oshwabadge2020/Badge-PCB/README.md

# Open Hardware Summit 2020 wrist-watch badge
* [Hackaday.io project page](https://hackaday.io/project/168483-open-hardware-summit-2020-badge)
* [OHS 2020 website](http://2020.oshwa.org/)

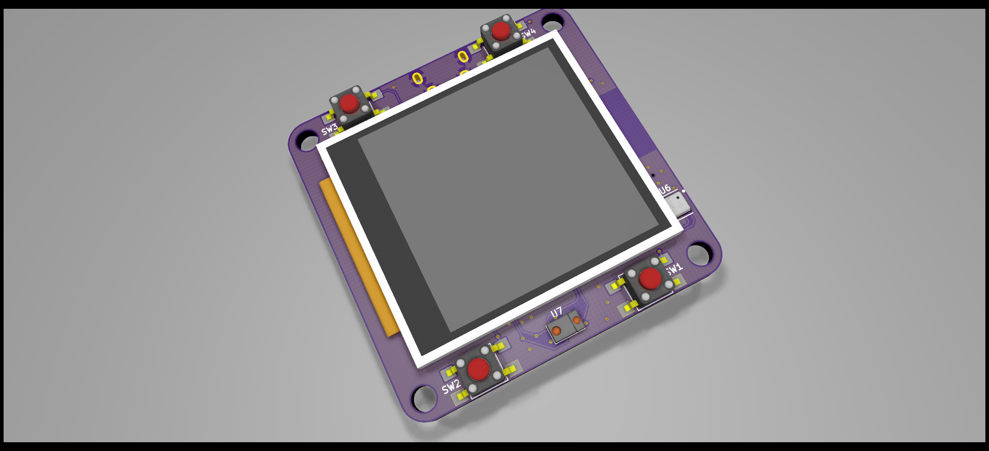
[picture p1: renders/badge-01.png]
Badge top

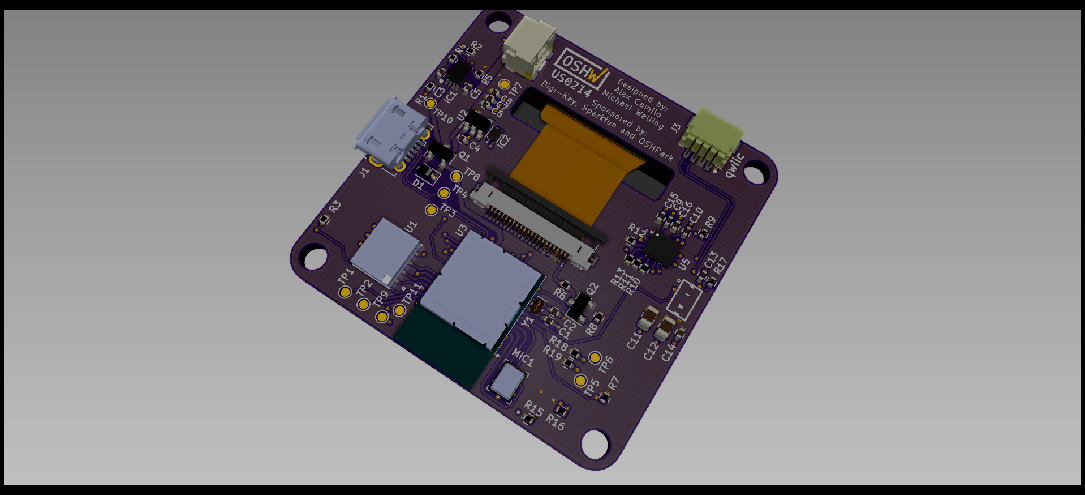
[picture p2: renders/badge-02.png]
Badge bot
