oshwabadge2020/Badge-PCB/3d_part_models/JST_GH_SM04B_SRSS_TB_LF__SN_007.step

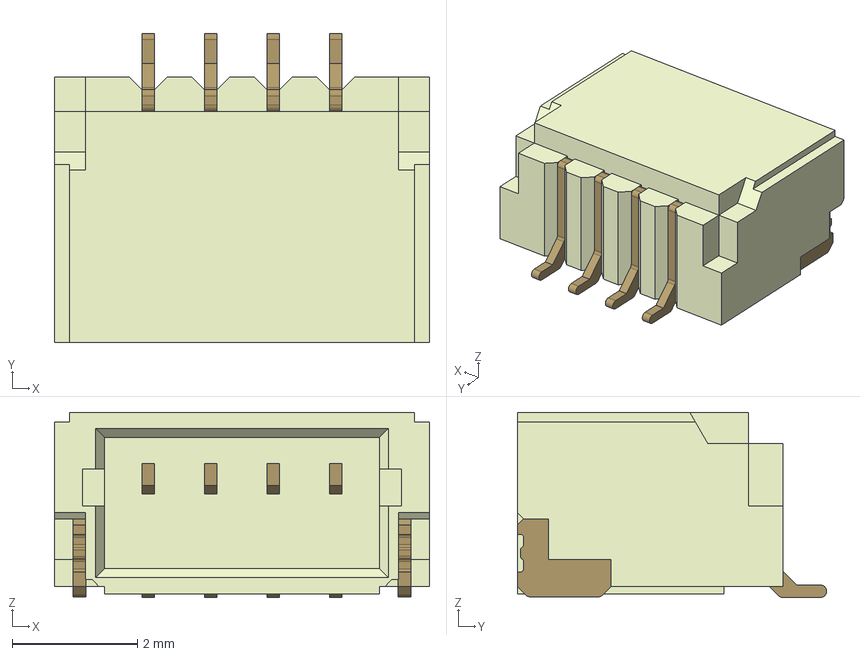
[picture p3: CAD file, 2020-01-16]
3d_part_models/JST_GH_SM04B_SRSS_TB_LF__SN_007.step
6.00 x 4.95 x 2.96 mm
