oshwabadge2020/Badge-PCB/CAD/TFT_LCD.step

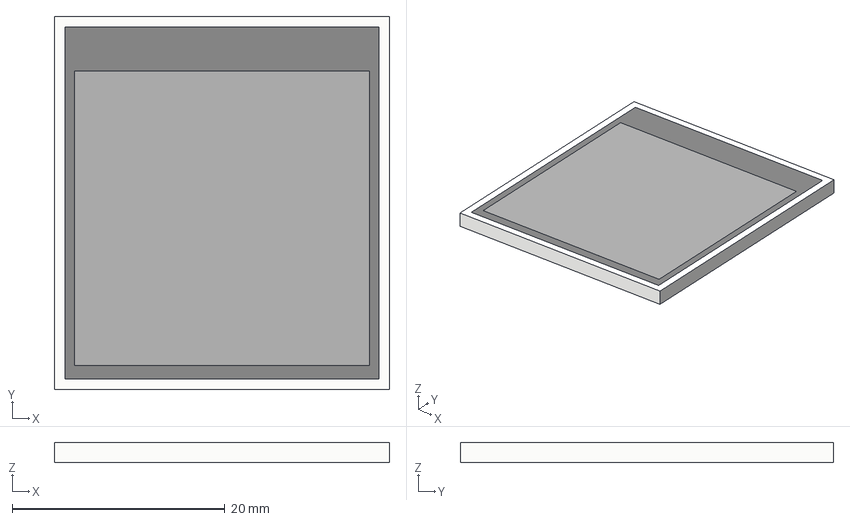
[picture p4: CAD file, 2020-01-14]
CAD/TFT_LCD.step
31.5 x 35.1 x 1.90 mm
TFT_1.54IN_240X240_22PIN
TFT_1.54IN_240X240_22PIN001
TFT_1.54IN_240X240_22PIN002
