oshwabadge2020/Badge-PCB/3d_part_models/TFT_LCD_4421.step

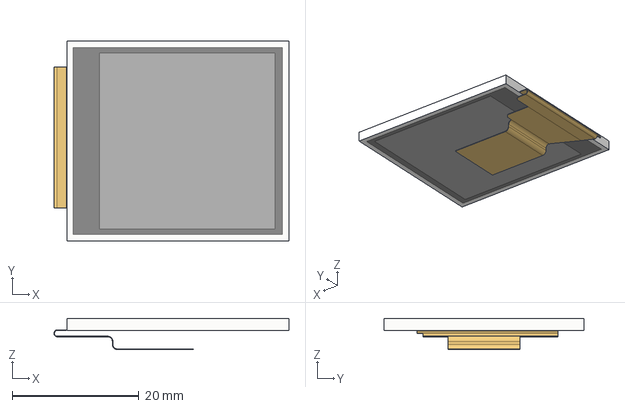
[picture p5: CAD file, 2020-01-14]
3d_part_models/TFT_LCD_4421.step
37.1 x 31.5 x 4.90 mm
