oshwabadge2020/Badge-PCB/3d_part_models/xtal_CM9V-T1A.step

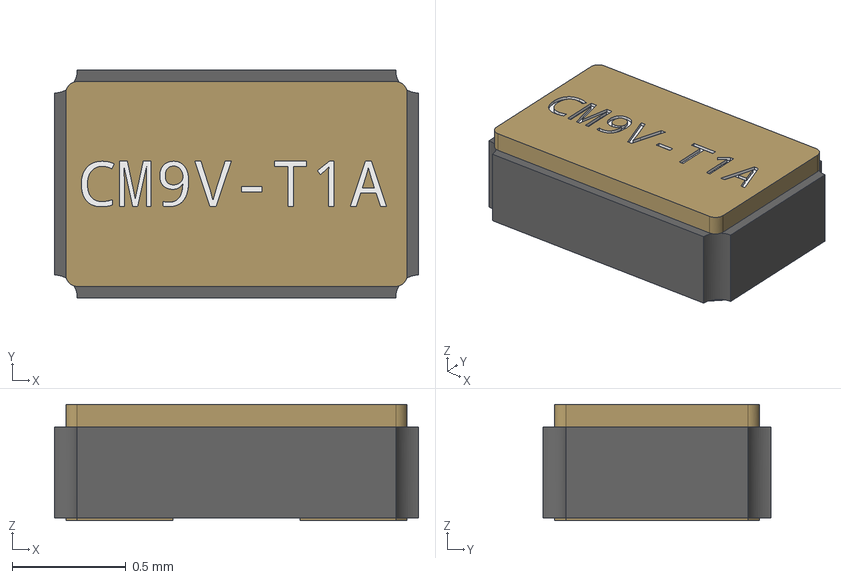
[picture p6: CAD file, 2020-01-12]
3d_part_models/xtal_CM9V-T1A.step
1.60 x 1.00 x 0.51 mm
