oshwabadge2020/Badge-PCB/3d_part_models/SNT-4A.step

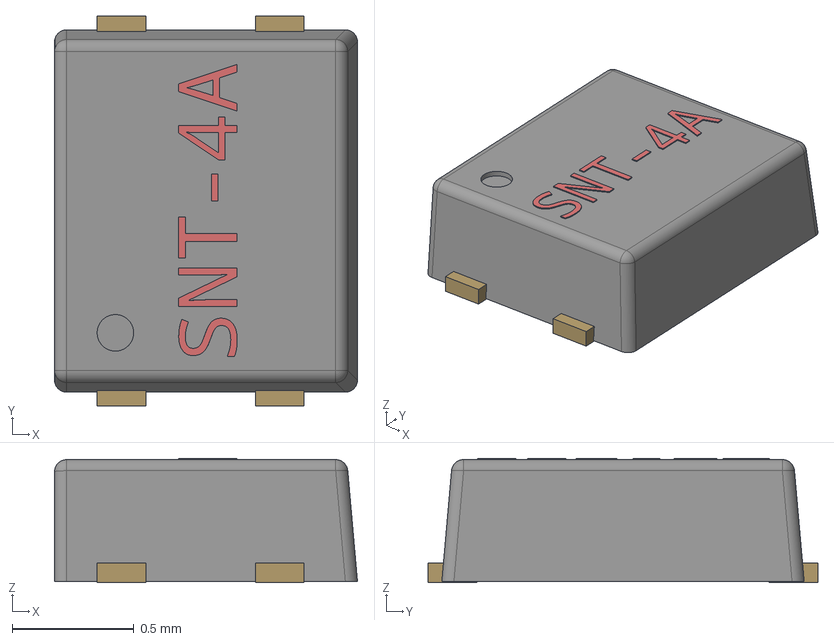
[picture p7: CAD file, 2020-01-12]
3d_part_models/SNT-4A.step
1.24 x 1.60 x 0.51 mm
