oshwabadge2020/Badge-PCB/3d_part_models/SON127P600X500X80-9N.step

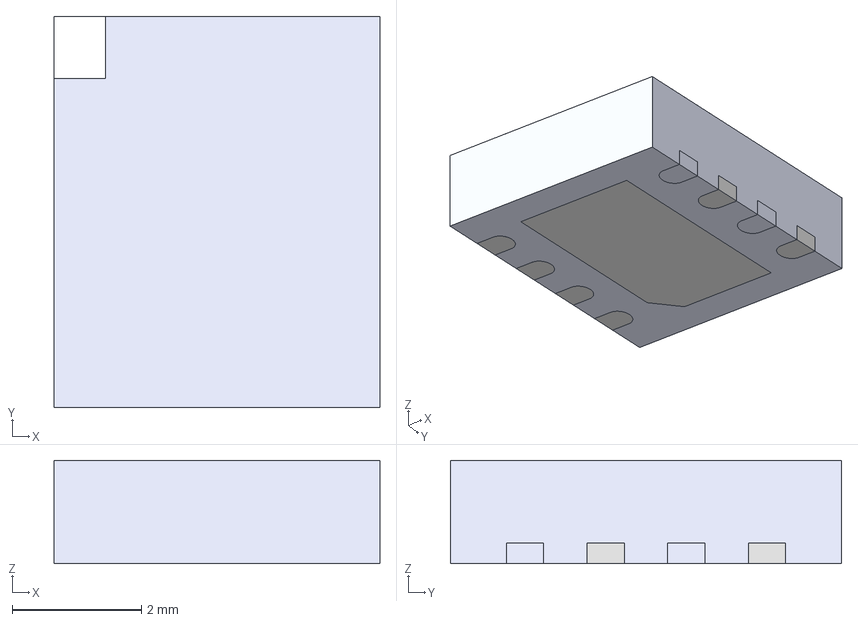
[picture p8: CAD file, 2020-01-12]
3d_part_models/SON127P600X500X80-9N.step
5.04 x 6.05 x 1.60 mm
