oshwabadge2020/Badge-PCB/3d_part_models/JST_GH_SM02B-GHS-TB_1x02-1MP_P1.25mm_Horizontal.step

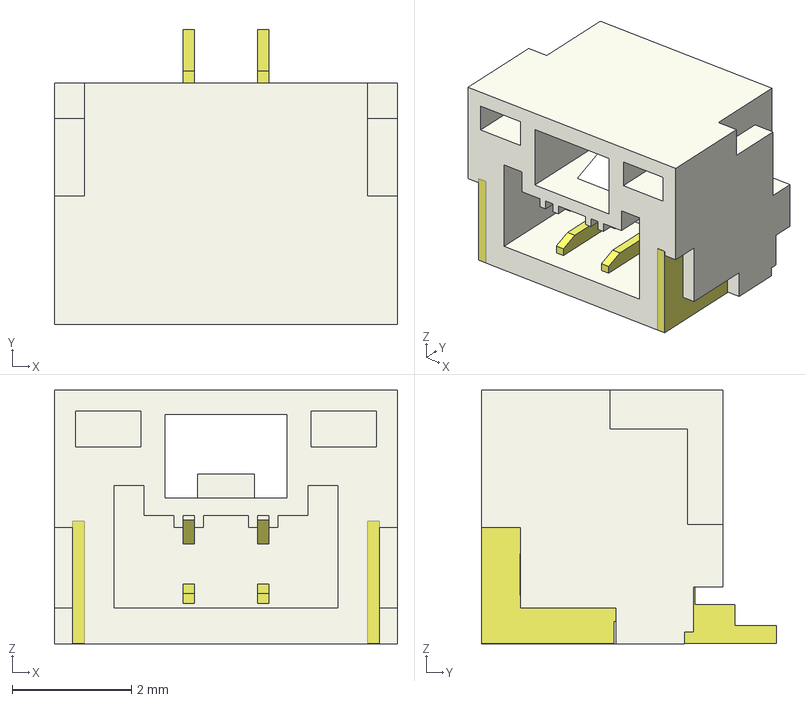
[picture p9: CAD file, 2020-01-12]
3d_part_models/JST_GH_SM02B-GHS-TB_1x02-1MP_P1.25mm_Horizontal.step
5.75 x 4.95 x 4.25 mm
