oshwabadge2020/Badge-PCB/3d_part_models/USB-MicroB_Molex_105017.step

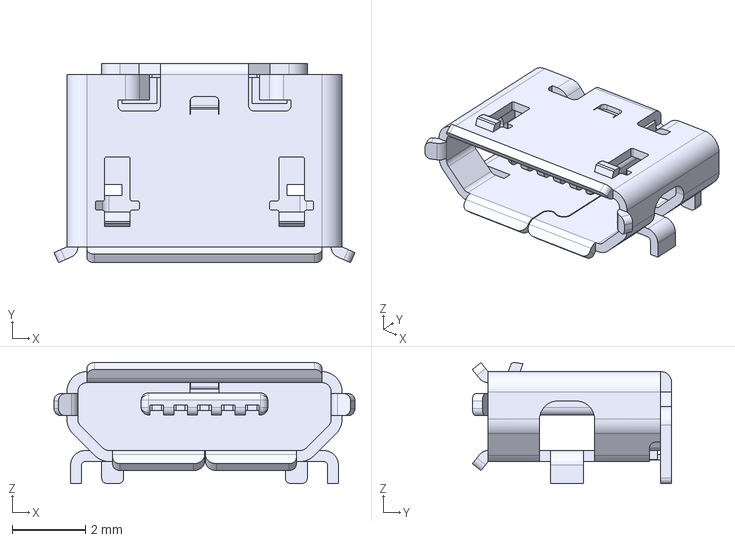
[picture p10: CAD file, 2020-01-12]
3d_part_models/USB-MicroB_Molex_105017.step
8.20 x 5.43 x 3.30 mm
