oshwabadge2020/Badge-PCB/3d_part_models/BME680_cp.step

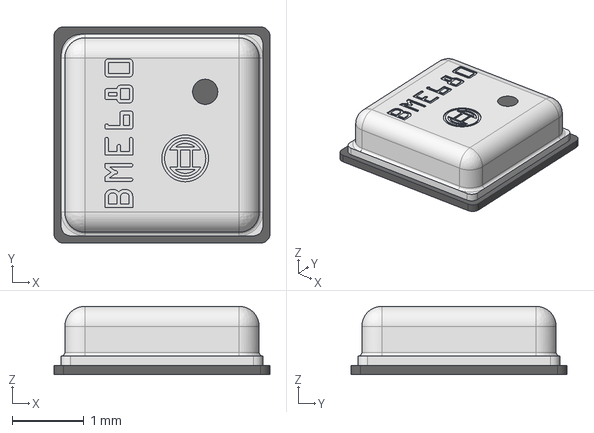
[picture p11: CAD file, 2020-01-12]
3d_part_models/BME680_cp.step
3.00 x 3.00 x 0.95 mm
