oshwabadge2020/Badge-PCB/3d_part_models/LGA-24L_3.5x3_0.43p.step

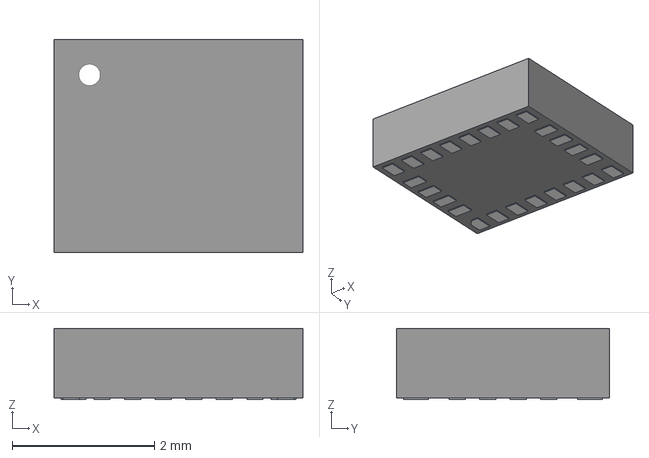
[picture p12: CAD file, 2020-01-12]
3d_part_models/LGA-24L_3.5x3_0.43p.step
3.50 x 3.00 x 1.00 mm
