oshwabadge2020/Badge-PCB/3d_part_models/SPH0645LM4H_B009.step

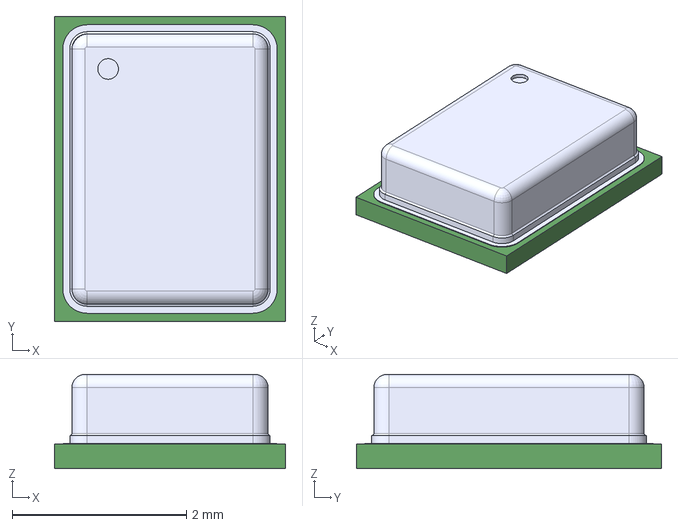
[picture p13: CAD file, 2020-01-12]
3d_part_models/SPH0645LM4H_B009.step
2.65 x 3.50 x 1.08 mm
