oshwabadge2020/Badge-PCB/3d_part_models/APDS_9962.step

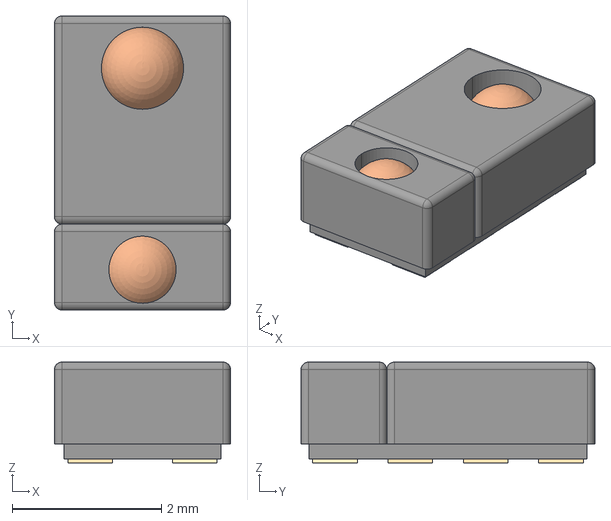
[picture p14: CAD file, 2020-01-12]
3d_part_models/APDS_9962.step
2.36 x 3.94 x 1.35 mm
