oshwabadge2020/Badge-PCB/3d_part_models/TL3305AFxxxxG.step

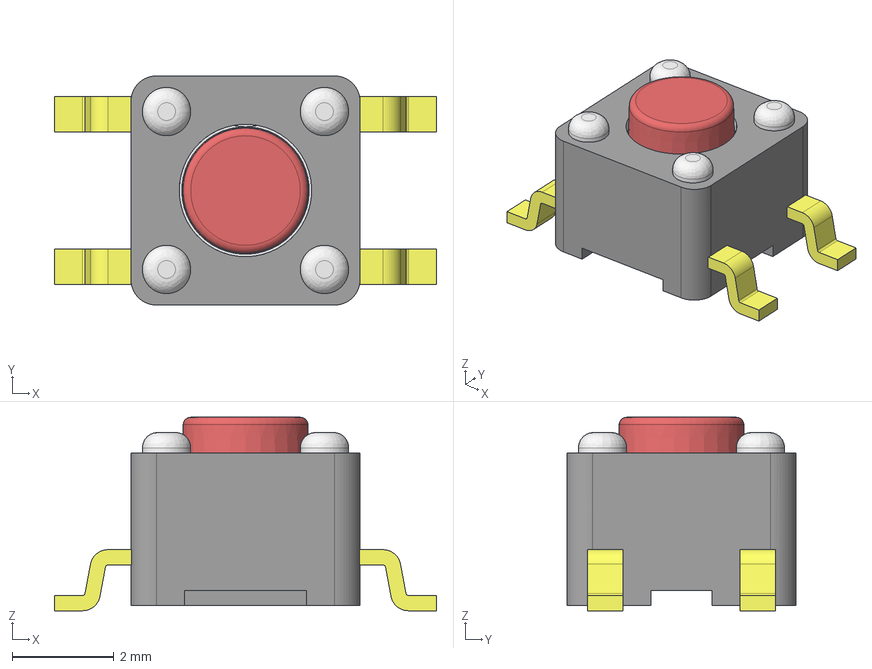
[picture p15: CAD file, 2020-01-12]
3d_part_models/TL3305AFxxxxG.step
7.50 x 4.50 x 3.80 mm
