oshwabadge2020/Badge-PCB/3d_part_models/BMD_340_A_R077.step

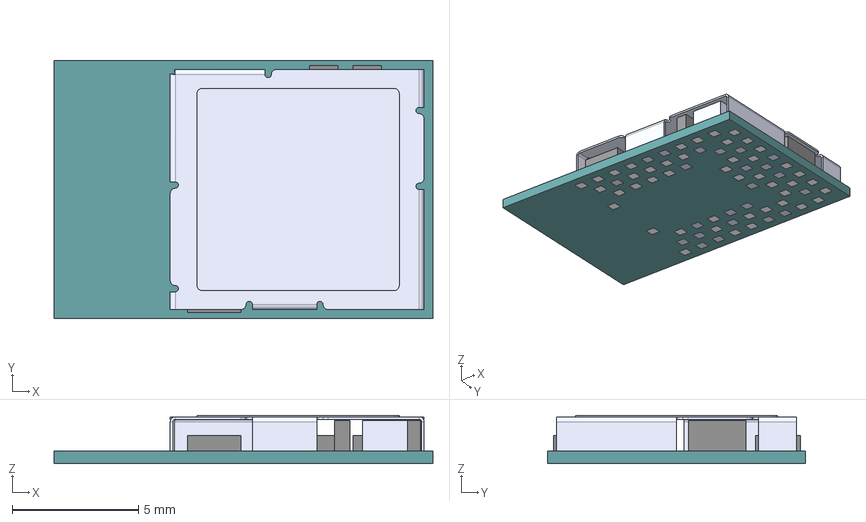
[picture p16: CAD file, 2020-01-12]
3d_part_models/BMD_340_A_R077.step
15.0 x 10.2 x 1.90 mm
