oshwabadge2020/Badge-PCB/3d_part_models/C_0805_2012Metric.step

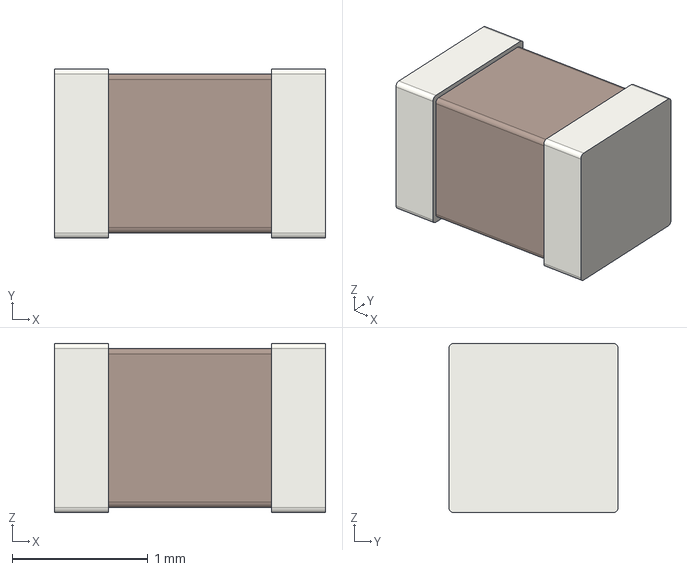
[picture p17: CAD file, 2020-01-11]
3d_part_models/C_0805_2012Metric.step
2.00 x 1.25 x 1.25 mm
