oshwabadge2020/Badge-PCB/3d_part_models/DFN8_2x3MC-L.step

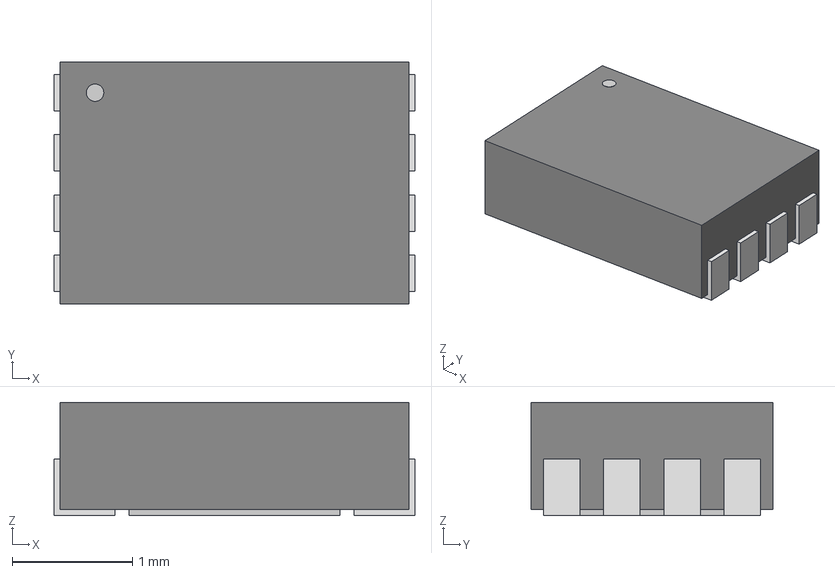
[picture p18: CAD file, 2020-01-11]
3d_part_models/DFN8_2x3MC-L.step
3.00 x 2.01 x 0.942 mm
