oshwabadge2020/Badge-PCB/3d_part_models/SOT-23.step

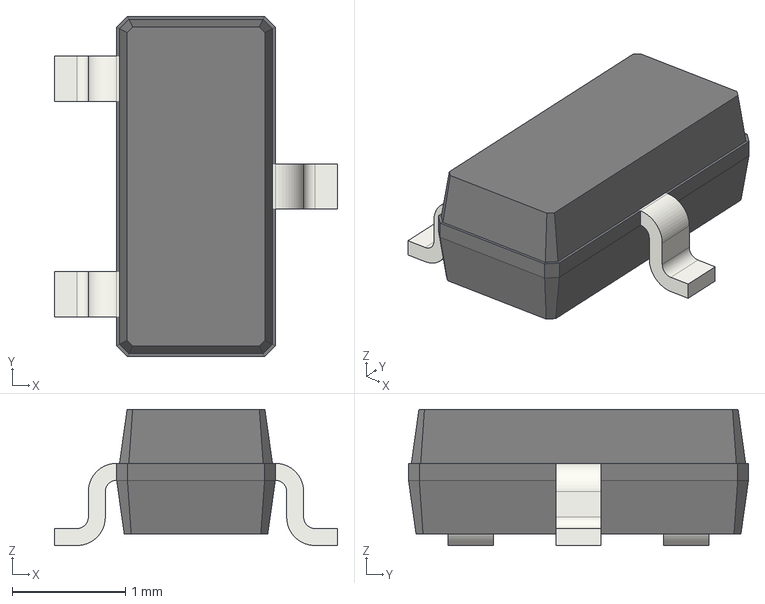
[picture p19: CAD file, 2020-01-11]
3d_part_models/SOT-23.step
2.50 x 3.00 x 1.20 mm
