oshwabadge2020/Badge-PCB/3d_part_models/D_SOD-323.step

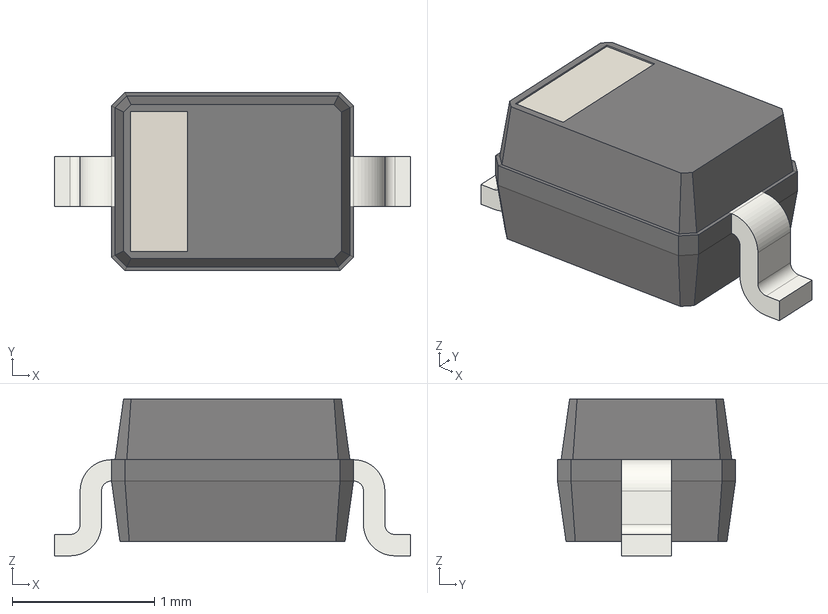
[picture p20: CAD file, 2020-01-11]
3d_part_models/D_SOD-323.step
2.50 x 1.25 x 1.10 mm
