oshwabadge2020/Badge-PCB/3d_part_models/TL3305CFxxxxG.step

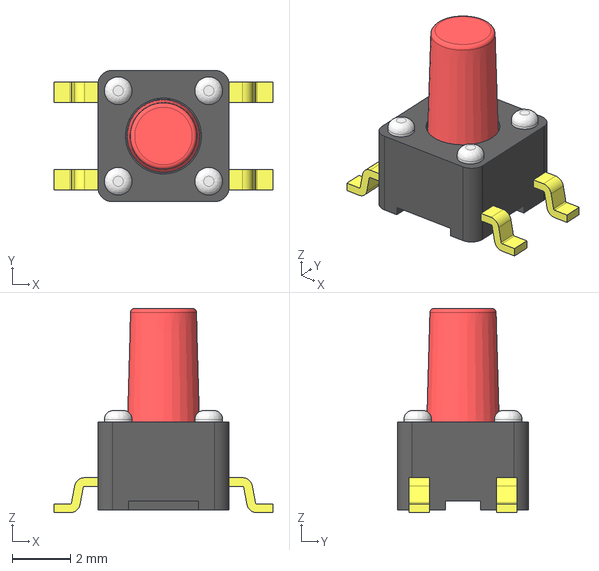
[picture p21: CAD file, 2020-01-11]
3d_part_models/TL3305CFxxxxG.step
7.50 x 4.50 x 7.00 mm
