oshwabadge2020/Badge-PCB/3d_part_models/C_0402_1005Metric.step

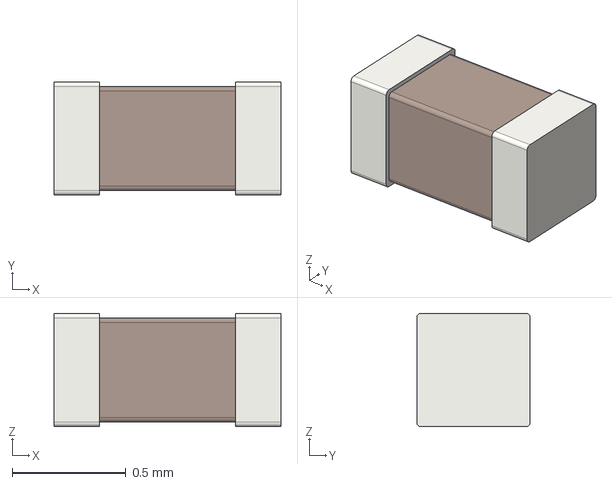
[picture p22: CAD file, 2020-01-11]
3d_part_models/C_0402_1005Metric.step
1.00 x 0.5 x 0.5 mm
