oshwabadge2020/Badge-PCB/3d_part_models/SOT-23-5.step

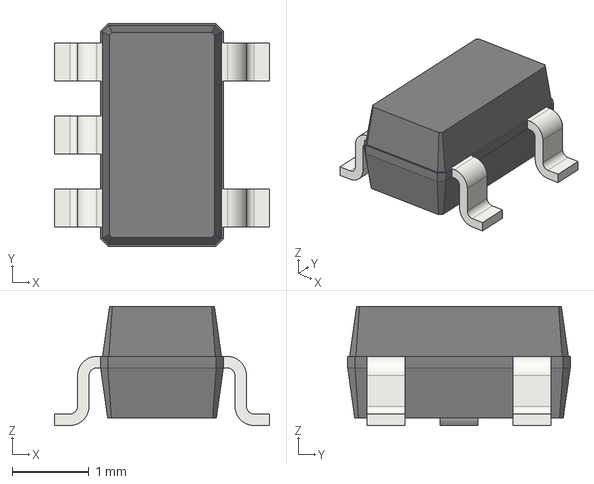
[picture p24: CAD file, 2020-01-11]
3d_part_models/SOT-23-5.step
2.80 x 2.90 x 1.55 mm
