oshwabadge2020/Badge-PCB/3d_part_models/LED_SK6812_PLCC4_5.0x5.0mm_P3.2mm.step

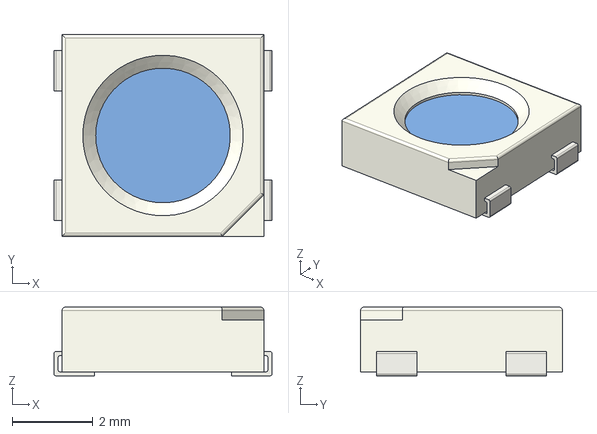
[picture p25: CAD file, 2020-01-11]
3d_part_models/LED_SK6812_PLCC4_5.0x5.0mm_P3.2mm.step
5.40 x 5.00 x 1.70 mm
