oshwabadge2020/Badge-PCB/(list of files, cad)

Other CAD files:
3d_part_models/JST_GH_SM04B-SRSS-TB.FCStd
3d_part_models/SM04B-SRSS-TB(LF)(SN)--3DModel-STEP-56544.step
3d_part_models/TFT_1_54IN_240X240_22PIN.step
3d_part_models/xtal.step
3d_part_models/DFN8_2x3MC-M.step
3d_part_models/DFN8_2x3MC.step
3d_part_models/0545482271.step
