oshwabadge2020/Badge-PCB/(threads)

Thread 1 (2019-12-12):

warning when opening schematic in KiCad 5.1

pdp7, 2019-12-12:
I got a warning when opening in KiCad 5.1 that the schematic was made using older symbol libraries which may break the schematic.  The reference was U1: W25Q128JVS

Here is screenshot:
Image: https://photos.app.goo.gl/DeDS7NZ7dhekTugQ7

I just thought I would check to see if this is an issue.

thanks,
drew

morganrallen, 2020-01-11:
This is also likely why the models aren't loading as per your .io post. Was this started in an older version of KiCAD? 4.0.7 maybe

Closed 2020-01-13.

Thread 2 (2019-12-13):

part number of LCD?

pdp7, 2019-12-13:
This is the LCD that I asked Kevin at Digikey about ordering from Adafruit.

1.54" 240x240 Color IPS TFT Display PRODUCT ID: 4421
https://www.adafruit.com/product/4421

Is this correct?

pdp7, 2019-12-15:
@acamilo on Hackaday.io chat today:
> the 1.3" adafruit LCD breakout. The Module with FFC connector. There are a couple of variants. there is a 1.54" with a FFF and a 1.3" with hotbar.  we don't want thoes.
we want the one  that is 1.3" with a FFC.

Kevin at Digi-Key has ordered:
* Adafruit 1.54" 240x240 Color IPS TFT Display PRODUCT ID: 4421

I just emailed Kevin and Phil at Adafruit to see if it is possible to get the display from:
* Adafruit 1.3" 240x240 Wide Angle TFT LCD Display with MicroSD - ST7789 (PRODUCT ID: 4313)

@acamilo it might be too late to change though.  Could you help me understand why we can not use Adafruit 1.54" 240x240 Color IPS TFT Display (PRODUCT ID: 4421)?

pdp7, 2019-12-16:
To followup, @acamilo told me on Hackaday chat that the case he found only fits the 1.3"

Phil replied to me that the 1.3" can not be sourced.

The solution is that we will go with the 1.54" and try to find a different case.

pdp7, 2019-12-16:
In conclusion: we will be using this display:

Adafruit 1.54" 240x240 Color IPS TFT Display PRODUCT ID: 4421

Closed 2019-12-16.

Thread 3 (2019-12-13):

use case for microphone?

pdp7, 2019-12-13:
I see the SPH0645LM4H-B is a microphone.

What sort of functionality where you thinking about for that?

@mwelling had mentioned TensorFlow Lite when we were talking about Artemis.  I wonder if that is still possible on the nRF52840

mwelling, 2019-12-13:
https://www.tensorflow.org/lite/microcontrollers

It should be possible with a fair amount of work.

I tried the Tensorflow Lite demo on the Edge Badge from Adafruit and it could not recognize me saying "yes".

I think that there were similar complaints about the SparkX Edge demo.

If we want to teach the module different words we will have to create a new model and quantize it for use with Tensorflow Lite.

pdp7, 2019-12-16:
@acamilo @mwelling OK, let's keep this on the "nice to have list".  If cost or board layout becomes issue, then I think we could drop the microphone.

sound ok?

mwelling, 2019-12-16:
Yes.

Closed 2020-01-13.

Thread 5 (2019-12-23):

layout: single board or 2 stacked boards?

pdp7, 2019-12-23:
I see that @mwelling is experimenting with a two board design based on the initial design by @acamilo.

Alex / Michael - do you think this will increase the complexity for SparkFun to assemble?  could we get away with one board, or do we have too many features to pack in to that space?

@nseidle @npoole would two boards for the OHS wristwatch badge be acceptable for sparkfun assembly?

thanks!

mwelling, 2019-12-23:
The boards will be a single assembly connected by mouse bites. It should not be any more difficult to assemble than a single board.

pdp7, 2019-12-24:
fyi - from the project chat:
[Stacking boards and wrist mounting options](
https://hackaday.io/project/168483-open-hardware-summit-2020-badge/log/172231-stacking-boards-and-wrist-mounting-options)

Closed 2020-01-13.

Thread 6 (2019-12-23):

Schematic: TFT part not found

pdp7, 2019-12-23:
@mwelling @acamilo I get this error when opening the schematic:
https://drive.google.com/file/d/1yV3evtUtcjzEU9EdJwjOczyqiNKNChYE/view?usp=sharing
https://drive.google.com/file/d/1z54ayqx_C5wUFP1OZ-xiHHbq0OHI8Zy6/view?usp=sharing

mwelling, 2019-12-23:
You just need to change to a relative path in the library path.

Lemme fix it on my fork.

mwelling, 2019-12-23:
https://github.com/mwelling/Badge-PCB/commit/2f8b797bd9968c6d512afe70e5037b96edf8f7c1

Closed 2020-01-13.

Thread 7 (2019-12-23):

Generate gerbers for review

nseidle, 2019-12-23:
I am not a proficient Kicad user. If possible, could you generate gerbers so I can review?

mwelling, 2019-12-23:
Yes we can provide Gerbers and PDF plots when we are ready for review.

pdp7, 2020-01-13:
For those without KiCad:

Gerbers:

https://github.com/oshwabadge2020/Badge-PCB/tree/master/gerbers

Schematic PDF:

https://github.com/oshwabadge2020/Badge-PCB/tree/master/schematic.pdf

OSH Park renders:

Here is PDF of layer preview from OSH Park:

https://hackaday.io/project/168483-open-hardware-summit-2020-badge/files

ZIP of the layer renders:

https://cdn.hackaday.io/files/1684837208376672/OSH%20Park%20_%20Verify%20your%20design.zip

OSH Park shared project has hi res top and bottom render:

https://oshpark.com/shared_projects/DU7vUFIe

Closed 2020-01-14.

Thread 15 (2020-01-13):

review layout before fab

pdp7, 2020-01-13:
Thanks so much to @mwelling  for finishing routing the badge:
https://github.com/oshwabadge2020/Badge-PCB/pull/14

Michael used 2 layers for the initial prototypes so we can fab them faster.  There are only 8 weeks left until the Open Hardware Summit on March 13th.

For those without KiCad:
* Gerbers: https://github.com/oshwabadge2020/Badge-PCB/tree/master/gerbers
* Schematic PDF:https://github.com/oshwabadge2020/Badge-PCB/tree/master/schematic.pdf

OSH Park renders:
* Here is PDF of layer preview from OSH Park: https://hackaday.io/project/168483-open-hardware-summit-2020-badge/files
* ZIP of the layer renders: https://cdn.hackaday.io/files/1684837208376672/OSH%20Park%20_%20Verify%20your%20design.zip
* OSH Park shared project has hi res top and bottom render: https://oshpark.com/shared_projects/DU7vUFIe

Related Hackaday.io post:
https://hackaday.io/project/168483-open-hardware-summit-2020-badge/log/172923-help-review-layout-before-fab

pdp7, 2020-01-13:
@Junes-PhD @Anool @acamilo @morganallen

Anool, 2020-01-13:
1. MIC1 hole needs to be 1mm per the [datasheet](https://github.com/oshwabadge2020/Badge-PCB/blob/master/datasheets/mic_SPH0645LM4H-B.pdf)

2. Some of the legend text is getting subtracted by Via's. You might want to move them around a bit for better visibility.

3. You might want to add some descriptive text/link about the project on the PCB silk legend.

I'll get time to take a closer look tonight,

Anool, 2020-01-13:
4. U7 Gesture sensor has silk outline on both sides of the PCB

ShawnHymel, 2020-01-13:
I believe that Q1 needs to be a P-channel MOSFET (as opposed to an N-channel). The body diode on the FET needs to allow current from +BATT to VBUS when the USB is not plugged in. I usually use Jim's design here for reference when I'm doing similar power circuitry: https://cdn.sparkfun.com/assets/learn_tutorials/5/0/7/esp32-thing-schematic.pdf

ShawnHymel, 2020-01-13:
Are 2 10uF capacitors needed at the output of U2? The datasheet for the S-1318 (https://www.mouser.com/pdfdocs/S1318_E.pdf) claims that you only need a single 1.0 uF at the output, so 2x 10uF might be overkill (and 10uFs can be a little pricey).

ShawnHymel, 2020-01-13:
Can the S-1318 produce enough power? The datasheet says that it's limited to 100mA. In my experience, for the APDS-9960 to detect gestures, it needs to enable a "BOOST" IR LED that can suck up to 100 mA in short bursts.

ShawnHymel, 2020-01-13:
According to 6.1 in the BME680 datasheet (https://www.bosch-sensortec.com/media/boschsensortec/downloads/datasheets_1/bst-bme680-ds001.pdf), you need to pull CSB up for I2C mode. Pulling it down activates SPI comms and disables I2C on the device.

ShawnHymel, 2020-01-13:
C15 may not be necessary if you've got bulk decoupling from the other 10uFs all over the board.

ShawnHymel, 2020-01-13:
What purpose do the D+ and D- test points serve? Will you actually be probing/sniffing USB traffic? I recommend not having test points for these lines, as they can create stubs on the differential pair for your data lines, which can cause reflections and mess up USB traffic.

schneider42, 2020-01-13:
Major:
 - Display IM0,IM1,IM2 usage is different from the one in the Rev G schematic from Adafruit
 - CSB of BME680 needs to be tied high to select I2C
 - Partnumber of SPI flash does not match package (should be W25Q32JVZP I guess)

Minor:
 - Maybe put the output of D3 onto a pad
 - Check size of solder mask defined pads of 0402s when doing a VCC/GND pour

Questions:
 - LDO has abs. max of 120 mA. I guess it is enough. Just wanted to verify.
 - Is 3.0 V enough for the backlight? Datasheet says 3.0 V _typical_

I didn't check much in the layout yet. Might have some more time tomorrow.

mwelling, 2020-01-13:
It is appears that Q1 and Q3 should both be P-channel MOSFETs. Switched to AO3401A.
Q2 looks wired wrong; switching it to P-channel high side switch as well to keep the BOM simple.

Beefed up U2 by using AP2112K-3.3V which gives us 600mA and 3.3V

CSB is now pulled up instead of down.

Switched the PN of U1 to W25Q32JVZPIQ.

Fixed the wiriing of IM0-IM2.

Looks like LCD_BL is not connected to a GPIO. Adding it.

Microphone pattern was not changes the AP diameter is as specified.

Soldermask defined pads should be okay.

We can tweak silkscreen and soldermask before final cut.

The test pads on the USB I assume are for use with a test fixture. Will check with Alex.

mwelling, 2020-01-13:
Updates are on my fork for verification:
https://github.com/mwelling/Badge-PCB

Please check my changes and make sure I didn't do something stupid.

mwelling, 2020-01-13:
The changes have been merged to this repo as well.

Junes-PhD, 2020-01-15:
*Probably minor notes*

RF layout recommendation for BMD-340 say to have a 4.4mm clear strip of
copper.  Wrapping the mic and copper pour around that antenna will reduce
range but not sure how much.  If the application is hand to phone it should
be fine but it's non-ideal for long mesh stuff and may need more broadcast
power.
BMD-340 Datasheet
<https://rigado.sharepoint.com/sites/Public/Shared%20Documents/Forms/AllItems.aspx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>
pg. 21

3V3 maybe better without big flood.  I would at least prefer to switch to
thermal relief for more consistent temperature rise on pads.

USB crosses over SPI lines and doesn't have continuous ground plane

ESD protection  maybe a good idea. USB lines and Switch inputs.

On Mon, Jan 13, 2020 at 3:08 PM Michael Welling <notifications@github.com>
wrote:

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

mwelling, 2020-01-15:
Thanks @Junes-PhD! Will take a look.

FYI. I just flipped the source and drain on Q2 on my repo. This makes it a proper load switch.

We need to change the circuitry on the RBG LEDs as it's FET is backwards as well and has 5V going to the BMD inputs. Was thinking we could maybe use a tps22919 or similar for the load switch.

pdp7, 2020-01-15:
@mwelling I've merged in your fix for Q2 https://github.com/oshwabadge2020/Badge-PCB/commit/d8f25c52f77bb43815fccb44903c51dd587437b2  thank you

mwelling, 2020-01-16:
So we sent off the boards to fab for initial protos.

Thank you to everyone that reviewed the design.

schneider42, 2020-01-17:
Good Luck!

schneider42, 2020-01-17:
One more thing from my side:

The AP2112K has a rather high quiescent current of 55 uA when active (which it will be unless the battery is empty). That will limit how long the RTC is be able to run after the software has decided that it is time to go into deep sleep until the next charge. Loosing the current time shortly after the badge shuts down is annoying.

Maybe the TCR2LF30,LM(CT is an option (200 mA)? Of course this can also be evaluated on the prototype itself and changed in the final layout. If the APDS-9960 low pass stays like that I'd be surprised if it goes over about > 70 mA.

Not sure if this is a concern for you. If yes I'm happy to open a new issue.

mwelling, 2020-01-17:
We can evaluate this on the protos.

Thread 25 (2020-01-18):

slot for backplate

pdp7, 2020-01-18:
I added a 22.5mm line for reference:

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

I think will need to widen the slot if we are using 22mm Nato watch band

pdp7, 2020-01-18:
The existing slot is 21.89 which is bit too tight I think:
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

Closed 2020-01-27.

Thread 27 (2020-01-28):

0603 capacitor specified for a 0402 pattern

mwelling, 2020-01-28:
https://github.com/oshwabadge2020/Badge-PCB/blob/master/badge.csv#L4

For the 10uF capacitors we have an 0402 footprint and an 0603 component specified in the BOM.

pdp7, 2020-02-10:
I am emailing kevin at digikey about this

mwelling, 2020-02-11:
We need to change the BOM inside the project to reflect an 0402 component.

pdp7, 2020-02-11:
@nseidle wrote:
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

pdp7, 2020-02-11:
@mwelling What do you think of this one?

311-1729-1-ND
CAP CER 10UF 6.3V X5R 0402 +/- 20%
https://www.digikey.com/product-detail/en/yageo/CC0402MRX5R5BB106/311-1729-1-ND/5195631

pdp7, 2020-02-11:
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
specified 0603:
>
> 311-1781-1-ND
> CAP CER 10UF 6.3V X5R 0603 +/- 10%
https://www.digikey.com/product-detail/en/yageo/CC0603KRX5R5BB106/311-1781-1-ND/5195683
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
https://www.digikey.com/product-detail/en/yageo/CC0402MRX5R5BB106/311-1729-1-ND/5195631
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

mwelling, 2020-02-12:
Looks good to me.

Closed 2020-02-13.

Thread 28 (2020-01-29):

USB VBUS connection

mwelling, 2020-01-29:
The R0 USB has connection issues.

This is due to the VBUS connection to the BMD-340.

The VBUS voltage going to the BMD-340 has a diode drop which causes issues.
Instead we should connect J1 (USB connector) pin 1 directly to U3 (BMD-340) pin 66.

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

Closed 2020-02-02.

Thread 29 (2020-01-29):

Diode D1 needs to be updated

mwelling, 2020-01-29:
The diode D1 needs to be adjust to something with less voltage drop under load.

Probably need to increase the pattern size to accommodate.

acamilo, 2020-02-02:
Bad diode, We don't need to fix this.

Closed 2020-02-02.

Thread 30 (2020-01-30):

Feedback from SparkFun assembly of R0 prototype

pdp7, 2020-01-30:
Feedback from @nseidle from visual inspection:
* Please camel case SparkFun in the 'sponsored by' silk
* The FP for the Winbond IC looks incorrect (too skinny for wide IC)
* I expect to see more solder on the underside of the microB connector (image below). We usually have solder paste go into the anchor holes. This FP looks very dry that may lead to microB connectors being wrenched off. I have plugged in a cable and it feels fine. Just looks off to me.
* (nit pick) If we can use the Qwiic logo on the board instead of 'qwiic' I would be grateful. SVG of Qwiic logo attached.
* The protos have white Qwiic connectors. This is an error by SparkFun. I think Digikey shipped us connectors so my team used them rather than black ones. We'll get black ones on there for the final assembly.
* There are mouse bites under the microB connector. These will be next to impossible to remove on final assemblies. I recommend moving the connector or talking to OSHPark about moving them (I don't think that's possible but maybe Drew knows more).
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

pdp7, 2020-01-30:
> There are mouse bites under the microB connector. These will be next to impossible to remove on final assemblies. I recommend moving the connector or talking to OSHPark about moving them (I don't think that's possible but maybe Drew knows more).

@laen tells me that we will be able to specify tab keepout area on the production run

pdp7, 2020-01-30:
> (nit pick) If we can use the Qwiic logo on the board instead of 'qwiic' I would be grateful. SVG of Qwiic logo attached.

I have uploaded the logo to images dir in this repo:
https://github.com/oshwabadge2020/Badge-PCB/tree/master/images

@acamilo @mwelling do you think there is space?

acamilo, 2020-02-02:
I'll fit in the QWIIC connector.
I could hand solder the USB connectors over a weekend if it proves to be a problem.

Closed 2020-02-07.

Thread 31 (2020-01-31):

Pinout of battery connector appears reversed

mwelling, 2020-01-31:
Looks like the VBAT and GND are swapped with respect to the battery we selected.

Please confirm and swap if necessary.

Closed 2020-02-02.

Thread 32 (2020-02-02):

QSPI IO0 and IO1 labels swapped

mwelling, 2020-02-02:
If you look at the QSPI flash in the schematic you will notice that IO0 pin connects to the IO1 net and the IO1 pin connects to the IO0 net.

Luckily we can swap these in the software but we should fix the net names to be correct.

acamilo, 2020-02-02:
Fixed.

Closed 2020-02-02.

Thread 33 (2020-02-03):

Short between 3.3V and SCL on some boards

mwelling, 2020-02-03:
2 of the 4 prototype units I was sent from Sparkfun had a short from 3.3V to SCL.

After inspecting the PCB layout, Alex noticed that the two nets are nearest under U5.

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

You will see that they directly adjacent and the solder mask is improperly specified for the pads allowing for easier shorts.

I recommend updating U5's pattern and possibly doing thermals on the power pour to avoid manufacturing issues. Couldn't hurt to check the paste apertures as well.

pdp7, 2020-02-05:
Is this fixed with https://github.com/oshwabadge2020/Badge-PCB/commit/0f4dcff1dcd95b07f539cf87d5421f1a353eb1b8 from @acamilo ?

pdp7, 2020-02-07:
@mwelling @acamilo Should I order new PCBs?

pdp7, 2020-02-07:
@nseidle Would you be able to look at the PCBs you received an check if there is short between TP5 to TP7, and TP6 to TP7?

We think the footprint on U5 was wrong.  Both the boards I received have I2C bus shorted.

mwelling, 2020-02-07:
We can leave this open until we find the source of the shorts.

siddacious, 2020-02-15:
probably not useful but I can confirm that VCC/3V and SCL are bridged on my board. I'll pull U5 and order a breakout from work for testing/dev until I can get an updated board

pdp7, 2020-02-15:
hopefully  this is resolved with the updated footprint for U5 on Rev1.

I just removed U5 from Rev0 so I could use i2c.

siddacious, 2020-02-15:
@pdp7 @mwelling here's a picture of my U5 pads after removal:
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
I'm near certain that this will be addressed by @acamilo 's fix

pdp7, 2020-02-15:
@acamilo did U5 work on your Rev1?

mwelling, 2020-02-15:
Yes it worked, he did the i2c scan yesterday and all of the devices appeared.

Thread 34 (2020-02-03):

CHDET pin from charger is not connected to nrf

mwelling, 2020-02-03:
If we wan't to check on the charging state we should connect this pin.

mwelling, 2020-02-07:
Looks like it has been resolved.

Closed 2020-02-07.

Thread 38 (2020-02-10):

push buttons to hard to press

pdp7, 2020-02-10:
@mwelling @acamilo I found that I am getting in imprint of the button on my thumb and it is annoying to press.

- use a variant with less force?
and/or:
- use a variant with taller actuator?

mwelling, 2020-02-13:
Here is a drop in replacement that is 160gf instead of 260gf:
https://www.digikey.com/product-detail/en/e-switch/TL3305AF160QG/EG5350CT-ND/5816195

Thread 39 (2020-02-10):

backplate artwork: digikey logo hard to see

pdp7, 2020-02-10:
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
The "Digi-Key" is just on mask and not copper so it is bare substrate.

This is also the case on "Electronics" for SparkFun.

pdp7, 2020-02-10:
@acamilo I can just change the layer of "Digi-Key" to silk so it is visible, unless you have another idea?

Also,  I plan to add:
- CircuitPython snake
- something like "with help from" Anool M. and Drew F.

pdp7, 2020-02-10:
merged #40

pdp7, 2020-02-10:
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

Closed 2020-02-10.

Thread 41 (2020-02-11):

no battery on BoM

pdp7, 2020-02-11:
https://github.com/oshwabadge2020/Badge-PCB/blob/master/badge.csv

pdp7, 2020-02-11:
1832-1032-ND
TinyCircuits ASR00007
3.7V Lithium-Ion Battery Rechargeable (Secondary) 290mAh

Thread 42 (2020-02-17):

Switch to open drain instead of push pull output

mwelling, 2020-02-17:
With the current configuration when the line drives high it fries the BMD-340.

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

Use MCP73832 instead.

mwelling, 2020-02-17:
Here is the open drain equivalent:
https://www.digikey.com/product-detail/en/microchip-technology/MCP73832T-2ACI-MC/MCP73832T-2ACI-MCCT-ND/7065592

Thread 45 (2020-03-07):

3D printable case

pdp7, 2020-03-07:
@anool has created a 3d printable case:
https://github.com/wyolum/Badge-PCB/tree/master/badge_3DP_enclosure

STL:
https://github.com/wyolum/Badge-PCB/blob/master/badge_3DP_enclosure/case_ver2/body_case2.stl

I need to figure out how to merge #44 without effecting the pcb layout

pdp7, 2020-03-07:
note: the current master from https://github.com/oshwabadge2020/Badge-PCB has an outline issue, while @Anool branch does not.  #43
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

pdp7, 2020-03-07:
@adamjvr @acamilo @siddacious if you have 3d printer, here is model from @Anool https://github.com/wyolum/Badge-PCB/tree/master/badge_3DP_enclosure

Thread 46 (2021-04-26):

BoM parts availabiity

Cipher2600, 2021-04-26:
I was attempting to gather the parts from DigiKey to create the badge as a project. Unfortunately, some of the parts are no longer available and/or have obscene long lead times. Drew recommended that I show which parts are no longer available and see if you have a recommended alternative. My knowledge on determining substitutes is limited to matching voltage, current, and form factor. If there is an important item that is not one of those, I will mess it up. Please see the attached spreadsheet with the listing of which parts are no longer available.

Any help would be most appreciated.
[OSN 2020 Badge BoM.xlsx](https://github.com/oshwabadge2020/Badge-PCB/files/6374222/OSN.2020.Badge.BoM.xlsx)

pdp7, 2021-04-26:
@acamilo @mwelling any thoughts about substitutions? thanks!

mwelling, 2021-04-28:
Sorry there is not much you can do about the BLE module, IMU, sensors. They are just not stocked right now.

Cipher2600, 2021-04-28:
That is what I thought. With the shortage of semiconductors worldwide, it hits everywhere. If possible, may I research possible alternatives and post them here to see if they would work? Like I said, I feel I am not fully knowledgeable to make that determination.

pdp7, 2021-04-29:
@Cipher2600 if you just wanted to develop with, then I should probably be able to send you one as I believe I have two.  Email me drew at oshpark.com and I will check _(moved from europe to USA in the mean time so I need to look in some boxes :)_.

If you were interested in the process of DIY assembling one yourself, then I think the supply chain issues will make that not practical.

Cipher2600, 2021-05-21:
Drew,
Just curious if you were able to find one. I ordered the boards and they came in yesterday. I will probably get a stencil for some of the parts.

If you are interested, I will keep you informed if I am successful in recreating the badge/watch.

Very Respectfully,
Anthony Monge

***Intercepted by the NSA. Read by the FBI.***

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

Thread 47 (2025-09-02):

Current Use?

Pixouls, 2025-09-02:
Hello! I got one of these in a conference swag bag a few years ago. I'm a beginner hobbyist. I tried plugging in the LiPo battery that came with it, but nothing happened, I can imagine that it might be dead after these years. I plugged in the screen and there was a generic QR code on it. Is there guidance on how to upload my own code or utilize the sensors on the device? I also noticed there's a 4 pin socket on the side, but it was unclear to me what it was for.
