oshwabadge2020/Badge-PCB/schematic.pdf/badge.pdf

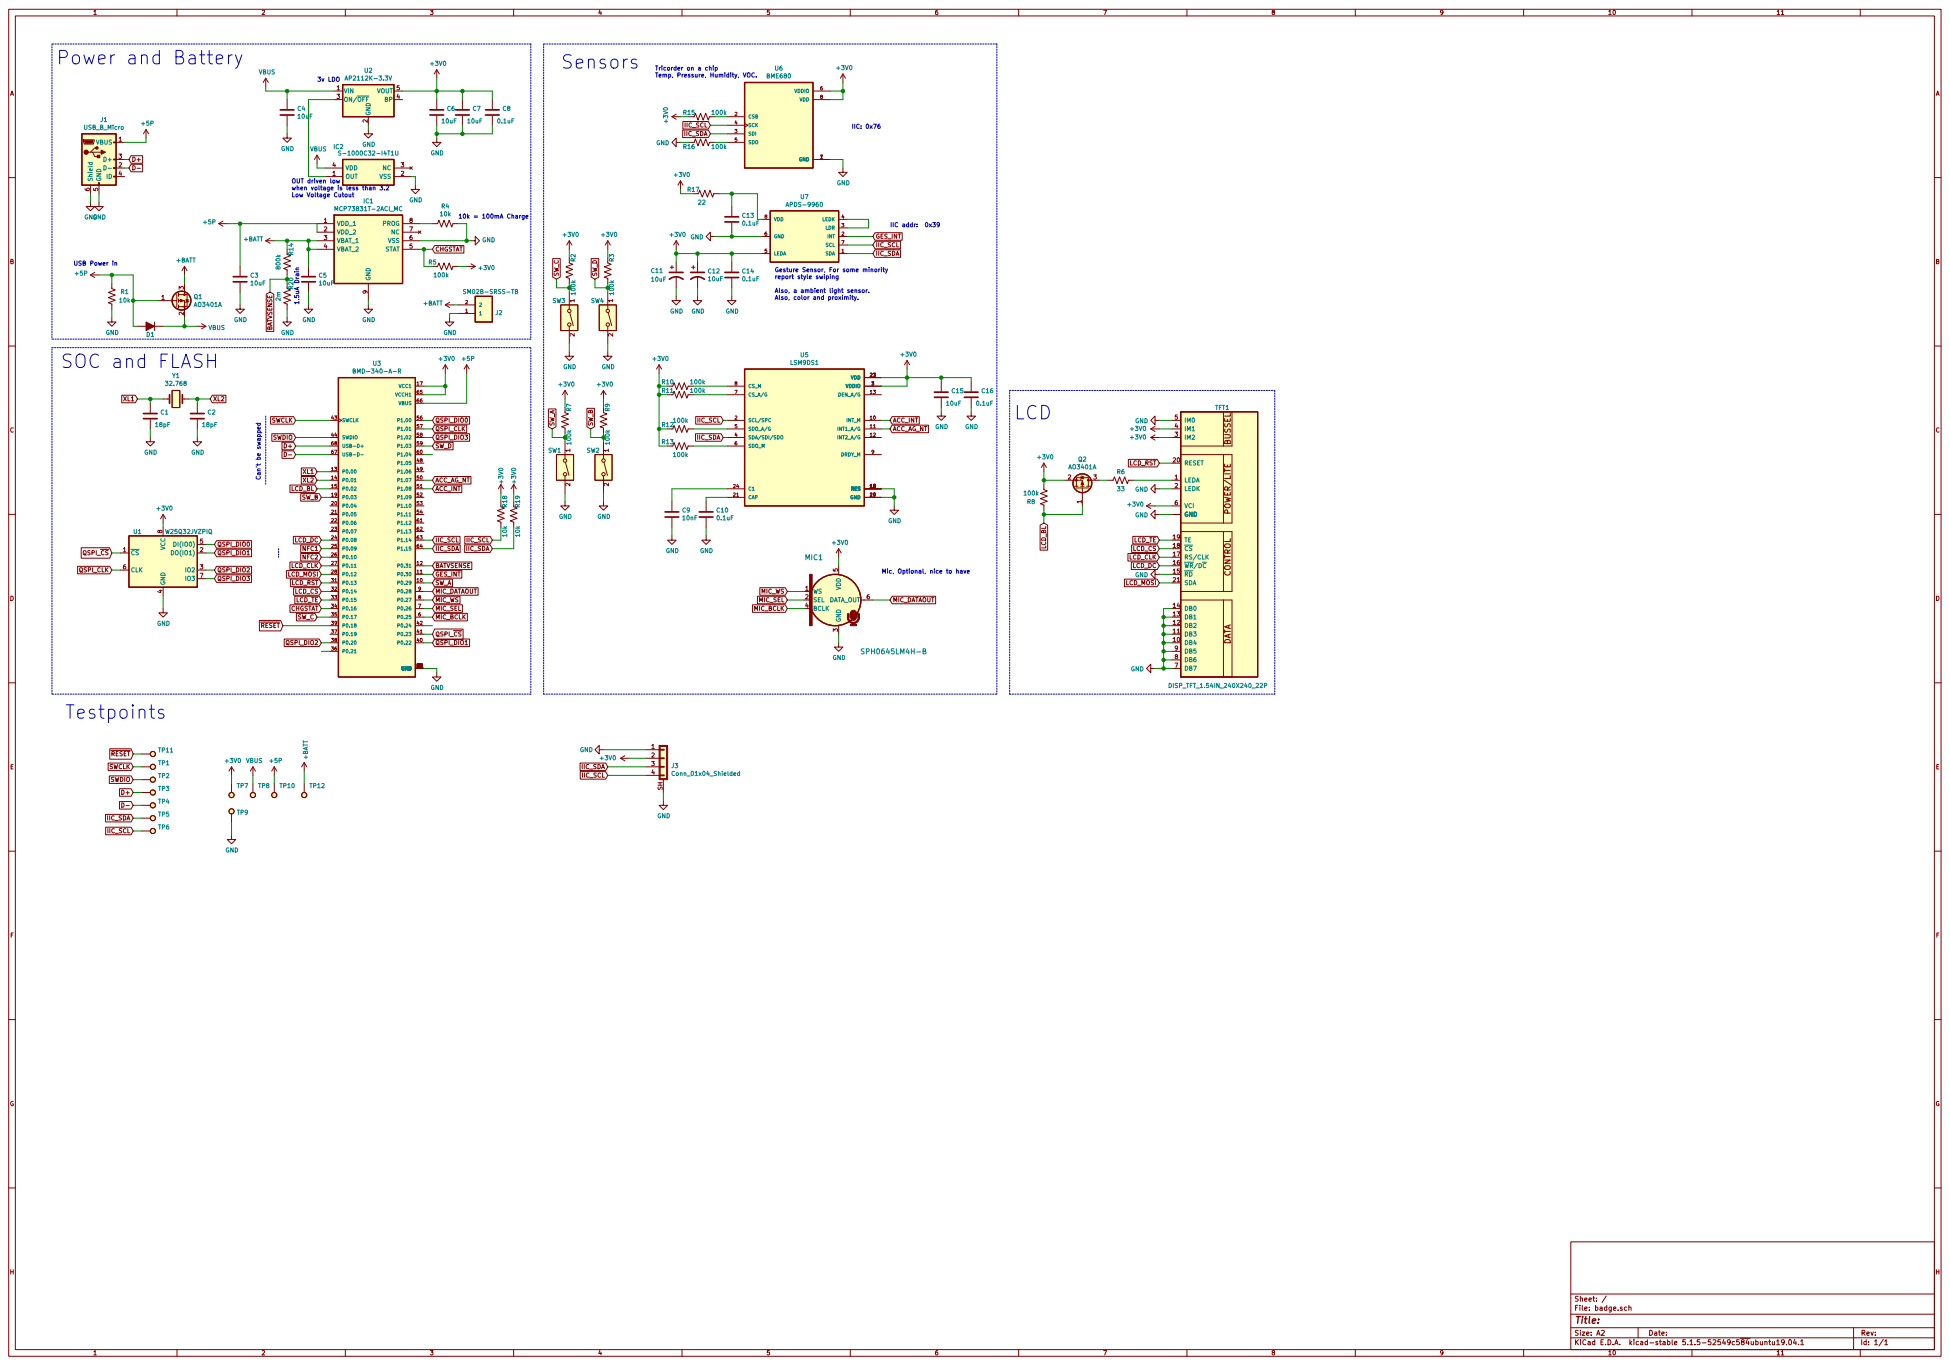
[picture p26: page 1]

Tricorder on a chip
Temp, Pressure, Humidity, VOC.

2 ON/OFF 3 BP 4 VOUT 5 U2 AP2112K-3.3V R18 10k TP10

when voltage is less than 3.2
Low Voltage Cutout
+BATT GND

USB Power in SOC and FLASH

Mic, Optional, nice to have 1.5uA Drain

Gesture Sensor, For some minority
report style swiping

Also, a ambient light sensor.
Also, color and proximity.

File: badge.sch Sheet: /
