oshwabadge2020/Badge-PCB/assembly/badge-B.Fab.pdf

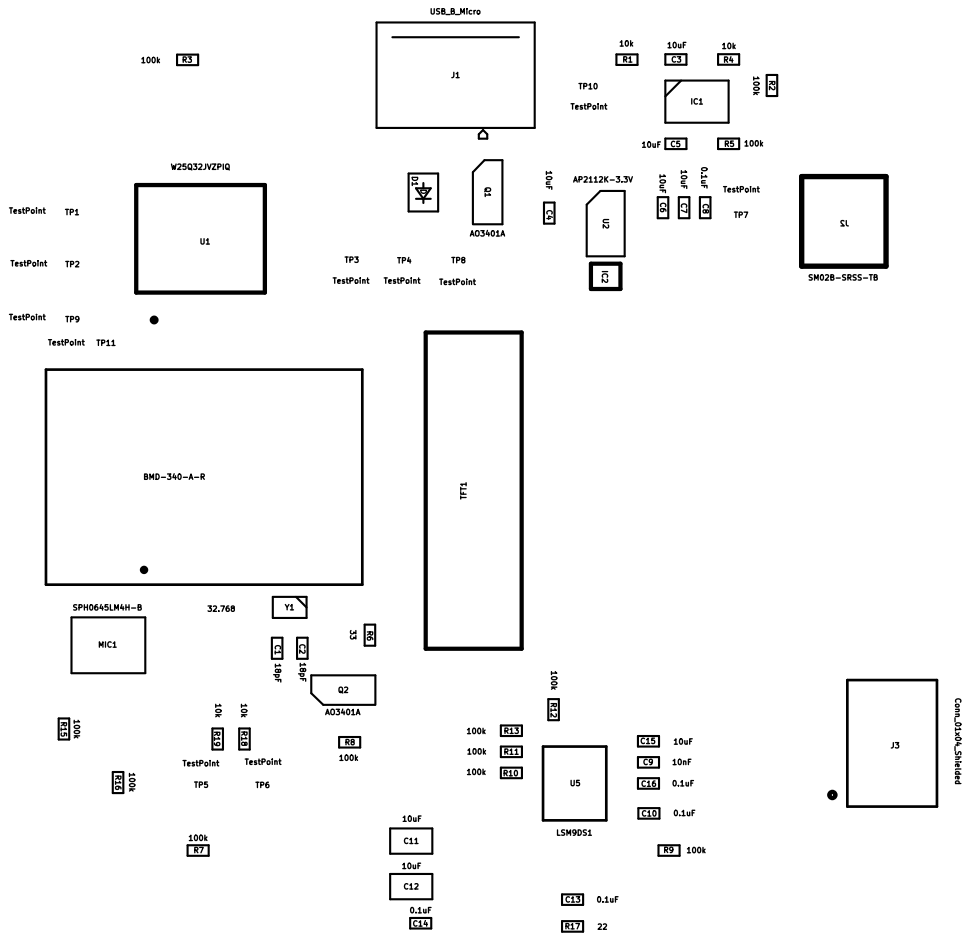
[picture p27: page 1]
