oshwabadge2020/Badge-PCB/assembly/badge-F.Fab.pdf

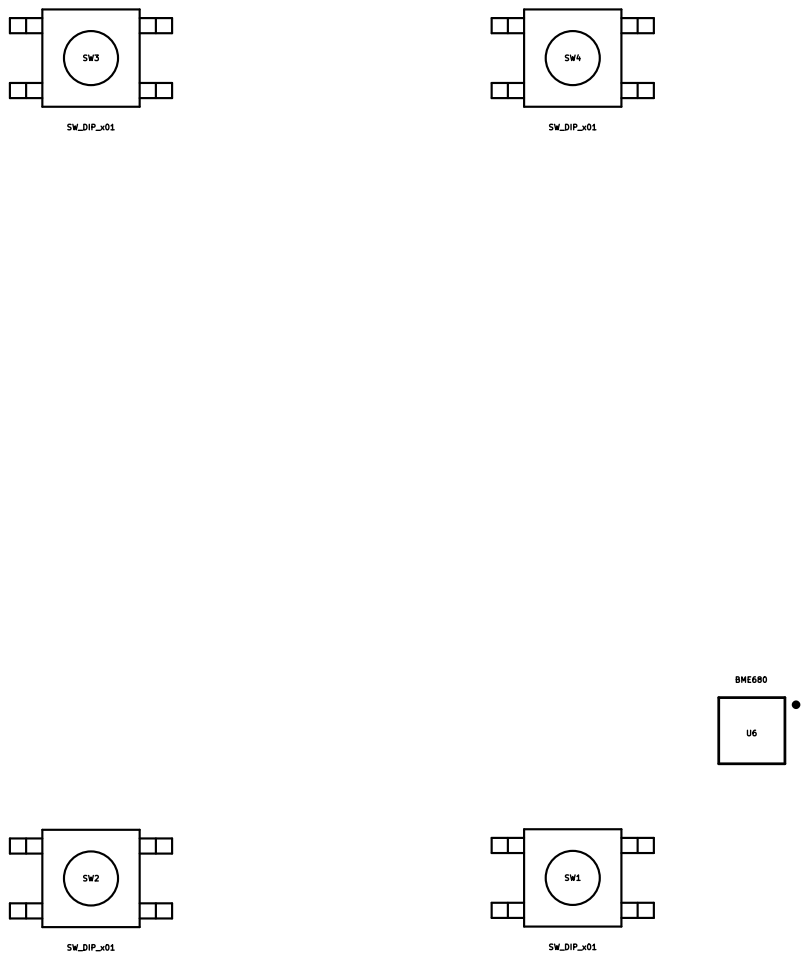
[picture p28: page 1]
