oshwabadge2020/Badge-PCB/images/DKE_Vector_K_NoOutline.pdf

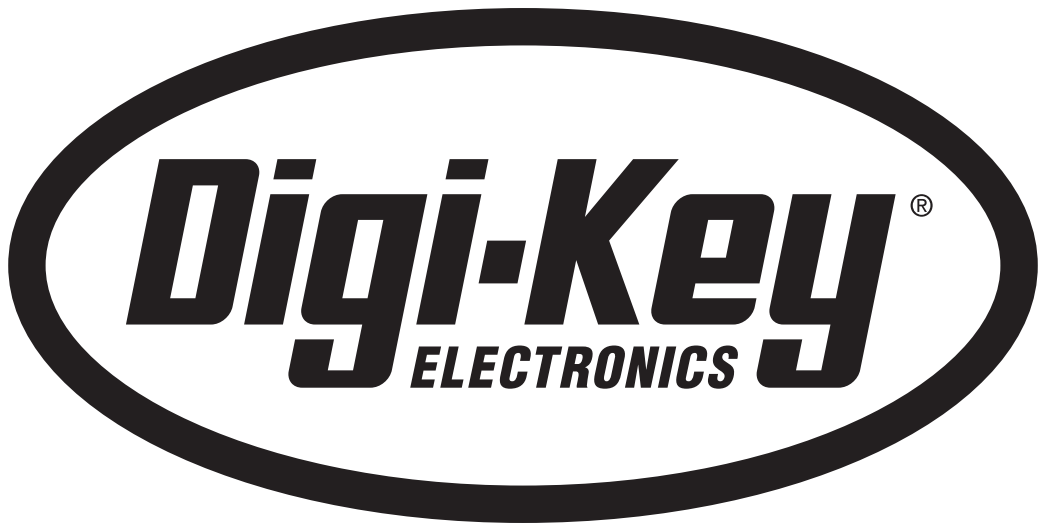
[picture p29: page 1]
