oshwabadge2020/Badge-PCB/(commit log)

2019-12-09 kicad proj stub
    [badge.kicad_pcb, badge.sch]
2019-12-11 Added more components and have a draft of the schematic
    [badge.sch]
2019-12-12 Added mic, LEDs, buttons
    [badge.sch]
2019-12-13 Added iic pullups
    [badge.sch]
2019-12-22 Start the PCB process
    Pulls in more PCB component footprints.
    Switched to 1.54" Display.
    May want to localize the libraries so that we don't have to rely on the global library setups of each developer.
    [badge.kicad_pcb, badge.sch]
2019-12-23 Start mechanical division into two boards
    We are going to sandwich two boards together much like card10 design.
    This is the start of planning for what will go on each half.
    The assemblies will be connected via mouse bites so we can use the same PCB doc for both.
    [badge.kicad_pcb, badge.sch]
2019-12-23 Switch to relative path for TFT lib
    Was set to local path for some reason.
2019-12-23 Chose 4.5mmsq switches, updated some footprints
    [badge.kicad_pcb, badge.sch]
2019-12-23 Changed FP for flash chip
    [badge.kicad_pcb, badge.sch]
2019-12-23 Switched to a micro jst conn for the battery
    [badge.kicad_pcb, badge.sch]
2020-01-03 Badge Outline
    [badge.kicad_pcb]
2020-01-07 imported new board outline
    [badge.kicad_pcb]
2020-01-07 Switched to microb
    [badge.kicad_pcb, badge.sch, badge.xlsx]
2020-01-07 Swapped FFC conn footprint for TFT
    [badge.kicad_pcb, badge.sch]
2020-01-07 began placement
    [badge.kicad_pcb]
2020-01-09 Update component placement
    The components all fit on the top PCB except the third push button.
    [badge.kicad_pcb]
2020-01-10 Remove one of the switches
    There isn't enough room for 3 switches.
    [badge.kicad_pcb, badge.sch]
2020-01-10 Remove bottom board from main PCB
    The bottom PCB is purely structural now.
    No need to panelize it for assembly.
    [badge.kicad_pcb]
2020-01-11 use local libraries only, added 3d models
    [545482271_cp.step, C_0402_1005Metric.step, C_0805_2012Metric.step, DFN8_2x3MC-L.step, DFN8_2x3MC-M.step, DFN8_2x3MC.step, D_SOD-323.step, JST_GH_SM02B-GHS-TB_1x02-1MP_P1.25mm_Horizontal.step]
2020-01-11 Move LCD connector closer to Rigado
    This allow the LCD to be closer to the center.
    [badge.kicad_pcb]
2020-01-12 added more 3D models for footprints
    [0545482271.step, 545482271_cp.step, APDS_9962.step, BMD_340_A_R077.step, BME680_cp.step, JST_GH_SM02B-GHS-TB_1x02-1MP_P1.25mm_Horizontal.step, LGA-24L_3.5x3_0.43p.step, SPH0645LM4H_B009.step]
2020-01-12 added final two 3D models and datasheets folder
    [SNT-4A.step, SON127P600X500X80-9N.step, badge.kicad_pcb, badge_bom_.xlsx, xtal.step, xtal_CM9V-T1A.step]
2020-01-12 Tweak the routing a bit
    Just merging some local change with the master repo.
    [badge.kicad_pcb]
2020-01-13 Completed routing in 2 layers
    Might want to find a way to avoid splits under the USB for better signal integritry.
    [badge.kicad_pcb, badge.sch]
2020-01-13 add gerbers and update schematic PDF
    [badge-B_Cu.gbr, badge-B_Mask.gbr, badge-B_Paste.gbr, badge-B_SilkS.gbr, badge-Edge_Cuts.gbr, badge-F_Cu.gbr, badge-F_Mask.gbr, badge-F_Paste.gbr]
2020-01-13 Updates per design review
    [badge.kicad_pcb, badge.sch]
2020-01-13 Update plots with review updates
    [badge-B.Cu.gbr, badge-B.Mask.gbr, badge-B.Paste.gbr, badge-B.SilkS.gbr, badge-B_Cu.gbr, badge-Edge.Cuts.gbr, badge-F.Cu.gbr, badge-F.Mask.gbr]
2020-01-14 added LCD 3D, improved symbol and fp library
    [0545482271.step, TFT_1_54IN_240X240_22PIN.step, TFT_LCD.step, badge.kicad_pcb, badge.sch]
2020-01-14 now with shiny flex cable on LCD
    [TFT_LCD_4421.step, badge.kicad_pcb]
2020-01-14 add STEP export of the board
2020-01-15 Flip source and drain on Q2
    [badge.kicad_pcb, badge.sch]
2020-01-15 Bottom outline footprint and pcb
    [backplate.kicad_pcb]
2020-01-15 Added 2 buttons and switched LED to ws2812b
    [badge.sch]
2020-01-15 added 2 buttons and a bottom LED
    [badge.kicad_pcb, badge.sch]
2020-01-15 86'd the LED
    [badge.kicad_pcb, badge.sch]
2020-01-15 Added Quicc
    [badge.kicad_pcb, badge.sch]
2020-01-15 Tidy up design
    Tweaks the routing, updates the silk and adds a 3d model for the QWIIC connector.
    [SM04B-SRSS-TB(LF)(SN)--3DModel-STEP-56544.STEP, badge.kicad_pcb, badge.sch]
2020-01-15 oshw on silk
    [badge.kicad_pcb]
2020-01-16 Remove extra logo in middle of board
    It was driving me nuts.
    [badge.kicad_pcb]
2020-01-16 better raytraced renders
    [JST_GH_SM04B-SRSS-TB.FCStd, JST_GH_SM04B_SRSS_TB_LF__SN_007.step, SM04B-SRSS-TB(LF)(SN)--3DModel-STEP-56544.STEP, SM04B-SRSS-TB(LF)(SN)--3DModel-STEP-56544.step, badge.kicad_pcb]
2020-01-17 update gerbers and schematic PDF
    This is the version that was ordered from OSH Park for initial
    prototypes
    [badge-B_Cu.gbr, badge-B_Mask.gbr, badge-B_Paste.gbr, badge-B_SilkS.gbr, badge-Edge_Cuts.gbr, badge-F_Cu.gbr, badge-F_Mask.gbr, badge-F_Paste.gbr]
2020-01-17 refill zones in the layout
    [badge.kicad_pcb]
2020-01-17 Add BOM
    [badge.csv]
2020-01-18 remove old BoM files
    [badge.xlsx, badge_bom_.xlsx]
2020-01-18 add 22.5mm line for reference
    we need to widen the slot if we are using 22mm Nato watch band
    [backplate.kicad_pcb]
2020-01-22 made slot big enugh for 22mm strap
2020-01-22 updated FP
    [backplate.kicad_pcb]
2020-01-22 add sponsor logo vector files
    [DKE_Vector_K_NoOutline.dxf]
2020-01-22 move sponsor logos
    [DKE_Vector_K_NoOutline.dxf]
2020-01-22 remove bad dxf file
    [DKE_Vector_K_NoOutline.dxf]
2020-01-22 PCB Artwork for sponsor logos
2020-01-22 update logos
    [backplate.kicad_pcb]
2020-01-22 combined artwork FP, updated PCB
    [backplate.kicad_pcb]
2020-01-23 add CircuitPython logo
2020-01-24 Added testpoint for battery
    [badge.kicad_pcb, badge.sch]
2020-01-27 Add assembly drawings for Sparkfun
2020-01-30 add Qwiic connector logo
2020-02-02 Fxied VBUS issue #28
    [badge.kicad_pcb, badge.sch]
2020-02-02 Swapped D0 and D1 pins for QSPI Flash, Issue #32
    [badge.kicad_pcb, badge.sch]
2020-02-02 Swapped Polarity of Battery Connector, Issue #31
    [badge.kicad_pcb, badge.sch]
2020-02-04 Added iic addrs and battery sense resistors
    [badge.sch]
2020-02-04 Added battery sense resistors and connected them and charger status to BMD
    [badge.kicad_pcb, badge.sch]
2020-02-04 Changed voltage sense pin to a pin that supports analog input
    [badge.kicad_pcb, badge.sch]
2020-02-04 Fixed PQFN24 footprint for accelerometer
    [badge.kicad_pcb]
2020-02-07 Add thermals to the 3.3V and GND pours
    Hopefully provides better yield.
    [badge.kicad_pcb]
2020-02-07 Camel Case'd SF Issue #30
    [badge.kicad_pcb]
2020-02-07 Modified Winbond IC footprint to accept wider chips. Issue #30
    [badge.kicad_pcb]
2020-02-07 Vias too close to new winbond IC pins. moved them up. Issue #30
    [badge.kicad_pcb]
2020-02-07 MIC hole was not 1mm
    [badge.kicad_pcb]
2020-02-07 Fancy QWICC logo, Issue #30
    [badge.kicad_pcb]
2020-02-07 Made pads on usb conn bigger to mae it more mechanically stable, Issue #30
    [badge.kicad_pcb]
2020-02-07 fixing errors in paste layer and silk
    [badge.kicad_pcb]
2020-02-09 add 2.9MM NPTH for M3 fp with 0.6mm clearance
2020-02-09 add M3 footprint to the four corners of badge
    [badge.kicad_pcb]
2020-02-09 update text on backplate
    [backplate.kicad_pcb]
2020-02-10 add CircuitPython logo and tweak backplate artwork
    [backplate.kicad_pcb]
2020-02-12 replace QR code on the backside of PCB
    [backplate.kicad_pcb]
2020-02-13 Fix #27 and #41 on BoM
    [badge.csv]
2020-02-17 Update badge.csv
    If the wrong variant is populated the badge self-terminates once the battery stops charging.
    [badge.csv]
2020-02-17 Update badge.csv
    Added bat voltage det resistors
    [badge.csv]
2020-02-18 update schematic for rev1
2020-02-18 add gerbers for 2x2 panel of rev1
    this was generated by Dan's oshpark script
2020-02-18 update gerbers for rev1
    [badge-B_Cu.gbr, badge-B_Mask.gbr, badge-B_Paste.gbr, badge-B_SilkS.gbr, badge-Edge_Cuts.gbr, badge-F_Cu.gbr, badge-F_Mask.gbr, badge-F_Paste.gbr]
