oshwabadge2020/Badge-PCB/(notices)

Notices in the files:
3d_part_models/R_0402_1005Metric.step:
Copyright (C) 2018, kicad StepUp
This work is licensed under the [Creative Commons CC-BY-SA 4.0 License](https://creativecommons.org/licenses/by-sa/4.0/legalcode),
with the following exception:
To the extent that the creation of electronic designs that use 'Licensed Material' can be considered to be 'Adapted Material',
You are free to use the library data in your own projects without the obligation to share your project files under this or any other license agreement.
3d_part_models/SOT-23.step:
Copyright (C) 2017, kicad StepUp
3d_part_models/LED_SK6812_PLCC4_5.0x5.0mm_P3.2mm.step:
Copyright (C) 2019, kicad StepUp
